dhdh05/air_quality_project/(list of files, drawings)

Other design files:
hardware/PCB1.PcbDoc
hardware/Sheet1.SchDoc
