dhdh05/air_quality_project/firmware/test/test_oled/test_main.cpp

#include <Arduino.h>
#include <Wire.h>
#include <Adafruit_GFX.h>
#include <Adafruit_SSD1306.h>

#define SCREEN_WIDTH 128
#define SCREEN_HEIGHT 64
#define OLED_RESET -1
#define OLED_ADDRESS 0x3C

Adafruit_SSD1306 display(SCREEN_WIDTH, SCREEN_HEIGHT, &Wire, OLED_RESET);

void setup() {
  Serial.begin(115200);
  delay(10);
  Wire.begin(21, 22);
  Serial.println("Test OLED");

  if (!display.begin(SSD1306_SWITCHCAPVCC, OLED_ADDRESS)) {
    Serial.println("Khong tim thay OLED");
    while (true) {
      delay(1000);
    }
  }

  display.clearDisplay();
  display.setTextSize(1);
  display.setTextColor(SSD1306_WHITE);
  display.setCursor(0, 0);
  display.println("AIR QUALITY TEST");
  display.println("OLED OK");
  display.println("ESP32 PlatformIO");
  display.display();
}

void loop() {
  delay(2000);
}
