dhdh05/air_quality_project/(commit log)

2026-07-12 final document of project
    [Book1.xlsx, PCB1.PcbDoc, Sheet1.SchDoc, ltinh.xlsx]
2026-07-12 chore: stop tracking generated and document folders
    [Book1.xlsx, PCB1.PcbDoc, Sheet1.SchDoc, ltinh.xlsx]
2026-07-12 Revise README for OLED display and relay updates
    Updated the README to reflect changes in OLED display behavior and relay control.
